StastnyJ/accelerometerPositionReader/src/sources.md

Files utilities.h, boards.cpp and boards.h are used for setup of the board. They were copied (and slightly changed) from [https://github.com/Xinyuan-LilyGO/LilyGO-T-Beam](https://github.com/Xinyuan-LilyGO/LilyGO-T-Beam).
