StastnyJ/accelerometerPositionReader/report/Report.pdf

## Substituting GPS with Gyroscope and Accelerometer

Jakub Sˇˇtastn´y

Student number: 03729788
Course: Real-time Systems [IN2060]

Abstract

I have built a device that measures the user’s current position and speed mainly using GPS and that tries to substitute the GPS with a gyroscope and an accelerometer in case of losing the GPS signal. I will describe the hardware from which the device is built in the first part. In the second part I will talk about the processing of accelerometer data, reducing measurements errors and calculating the final position of the device in the earth coordinates system. In the last part I will talk about the precision of the device and about the cause of the errors.

Substituting GPS with Gyroscope and Accelerometer | Jakub Sˇˇtastn´y

## 1 Project description

In this project I have built the device that shows the user his/her current position and speed on the display in a real time. In a normal case, the device is using only a GPS chip in order to get the information about the current location. But there are many cases when we lose a GPS signal. For example inside some buildings, between high mountains, in tunnels, etc. We want to have the device still running in these cases, so we have to substitute the GPS with some other alternative that is independent of the quality of a signal. I decided for the gyroscope and accelerometer that can measure our acceleration and angular speed, which can be using double integration converted to the relative location¹ and combined with the last location that the GPS measured before it lost the signal, in order to calculate the current location. With this technique we can keep the device running and providing the output to the user for the whole time even if we do not have any signal. Besides the controller board, accelerometer, gyroscope and display, the device contains two additional buttons. One of them is used for the (re)calibration of the device (described later). The second button is present only for the testing purpose and is used for the simulation of the situation that we do not have any GPS signal. If a user presses this button, he/she turns on the testing mode so that the device does not use any information from the GPS, even if it has a GPS signal and calculates the current speed and location only using the accelerometer and gyroscope data in order to simulate and test the situation that we do not have a GPS signal. If the user presses the button again, the testing mode is turned off and the device is working normally.
The device also has one additional LED, which indicates that the testing mode is turned on.

The whole project including all source codes, this report and photos is available on my github. https://github.com/StastnyJ/accelerometerPositionReader

## 2 Used hardware

For this project I used following hardware:

1. LILYGO TTGO T-Beam V1.1²
2. MPU-6050 3 Axis Gyro With Accelerometer³
3. OLED 128x64 I2C SSD1315 12864 LCD Screen Display module⁴
4. 2 Buttons, 1 LED and 18650 Battery

### 2.1 Controller board

As a microcontroller for this project, I used LILYGO TTGO T-Beam board version 1.1. This board is based on the ESP32 processor. It offers 4 MB Flash memory and 4 MB of PSRAM. The board also contains 2 additional modules. First of them is module LoRa32 which is used for wide area communication via bluetooth and WiFi. I haven’t used this module for the project. The second and for the project more important module is the NEO-6M module used for GPS. This module
can measure current gps location with the accuracy up to 2.5 meters⁵ | . This module communicates
with the ESP processor via integrated serial BUS in format of NMEA sentences⁶

1The location difference between our current location and location before the start of the acceleration measurement
2Detailed description: https://www.banggood.com/LILYGO-TTGO-T-Beam-ESP32-433-or-868-or-915-or-923Mhz-V1_

1-WiFi-Wireless-bluetooth-Module-GPS-NEO-6M-SMA-LORA32-18650-Battery-Holder-With-OLED-p-1545070.
html (https://www.banggood.com/LILYGO-TTGO-T-Beam-ESP32-433-or-868-or-915-or-923Mhz-V1_1-WiFi-Wireless-bluetooth-Module-GPS-NEO-6M-SMA-LORA32-18650-Battery-Holder-W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)
3Detailed description: https://www.banggood.com/3pcs-6DOF-MPU-6050-3-Axis-Gyro-With-Accelerometer-Sensor-Controller-Module-p-1430733.

html (https://www.banggood.com/3pcs-6DOF-MPU-6050-3-Axis-Gyro-With-Accelerometer-Sensor-Controller-Module-p-1430733.html)
4Detailed description: https://www.amazon.com/Serial-Display-Module-SSD1315-arduino/dp/B07Y5HNJGL
5This accuracy can be achieved only with a quite good antenna or a clear sky view. With the antenna I used for
the project is the accuracy between 15 and 20 meters.
6Described here: http://aprs.gids.nl/nmea/
1 | February 4, 2021

### 2.2 Gyroscope and Accelerometer

The MPU-6050 is a 3 axis gyroscope and accelerometer, which can communicate via I²C protocol. The accelerometer can measure the acceleration in the x, y, and z axis⁷
. With the configuration
I used to the project, the accelerometer can measure in each axe the acceleration in range from -2 g to 2 g with the sensitivity 6.1 · 10⁻⁵
g. The gyroscope can measure the angular speed of a board around each x, y and z axe. It can be measured in range from -250 ◦
s

−1

to 250 ◦
s

−1 with
the sensitivity 7.6 · 10⁻³ ◦ s

−1

### 2.3 Display

To display current speed and location to the user I used OLED 128x64 12864 LCD Screen Display. This display communicates again via I²C protocol. The screen is 128 pixels wide and 64 pixels high.

### 2.4 Circuit

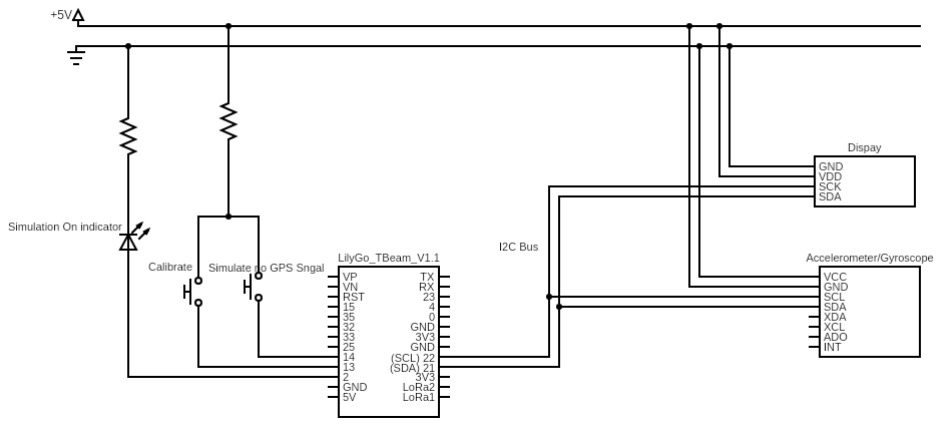
[picture p8: figure]

Figure 1: Circuit scheme (power supply of the TBeam board and power lines connection left out)

## 3 Reading and processing accelerometer and gyroscope data

The main challenge of the processing the accelerometer data is the fact that we receive the acceleration relatively to the accelerometer module and not relatively to the earth coordinate system and we need to convert them so we can calculate the final location. Furthermore, for the conversion we need an orientation of the board relatively to the earth coordinates which is not so easy to get without a tilt sensor or something similar.

### 3.1 Processing and converting raw data

As mentioned earlier, we obtain the accelerometer data relatively to the module axis. From the accelerometer and gyroscope we receive three 16-bit integers that correspond to the acceleration in x, y and z axes multiplied by 16384 in multiplies of g. After these 3 numbers, there follow three other 16-bit integers that correspond to the angular speed around x, y and z axes multiplied by 131 in degrees per second.

7The axis are defined relatively to the accelerometer and not in earth coordinate system

2 | February 4, 2021

For this part, let’s assume that we know the exact orientation of the module relatively to the earth coordinate system. If we know the orientation we can easily convert received acceleration data to the earth coordinates system that we convert received acceleration vector to the polar coordinates system, than we can easily rotate the vector by the orientation vector and then convert back to the Cartesian coordinates system and we obtain a vector of accelerations in x, y and z axe relatively to the earth coordinates system.

### 3.2 Device calibration

In this section I will talk about the way how can be obtained the orientation of the accelerometer module relatively to the earth coordinates system using only gyroscope and accelerometer. The calibration is a process that starts after a user presses the calibrate button and takes ca 10 seconds. During the calibration the device can be rotated as desired, but it must not move for the whole time. The main goal of the calibration is to obtain the orientation of the module relatively to the earth coordinates system. During the calibration we also calibrate the gyroscope so that it measures the correct data.
If the device is in calm, we expect the acceleration 0 in x and y axes and -1 g in z axe⁸
if the
module coordinates would be the same as the earth coordinates. During the calibration time we measure the current acceleration. In order to minimize the error of the measurement, we measure the acceleration multiple times and after we have enough measurements we can calculate the average value and use it for the further calculation. After theses measurements we have information about the calm acceleration relatively to the module which is usually different from the expected [0, 0, −1] g vector. At this point we can convert both vectors to the polar coordinates system and calculate the rotation differences between both vectors. In other words, we can calculate how we should rotate the measured vector so that we obtain the expected vector, which is the information about the module orientation that we need for the conversion to the earth coordinates system. At this point we know the initial orientation of the device. But this orientation can change during the usage of the device and changes quite often. To handle this, we can use the data from the gyroscope. The gyroscope measures the angular speed of the module, so if we detect that there is some angular speed around any axe different from 0, we know that the user tilted the device, and we can accordingly adjust our information about the orientation. Updating the orientation is the only part for which I am using the gyroscope in the project.
The last thing I am doing during the calibration process is the calibration of the gyroscope. Because of the construction error, almost each gyroscope has shifted the 0 levels of the angular speeds. During the calibration process I can also measure the gyroscope values (and calculate their average). Because the device is in calm, the measured values should be all 0, but because of the shift error, each value is shifted, so we obtain the error shift values that we can further subtract from the measured values in order to get the right angular speeds.

### 3.3 Data smoothing

From this point we know how to recalculate the measured values to the earth coordinates system, so we will assume that all accelerations are in the earth coordinates system.
In this section I will talk about the preparation of the measured data before we can start the final computation of the speed and location. The problem, why we shouldn’t directly calculate speed and location from the measured date, is that because of the double integration, even small measurement errors can have huge consequences, and we have to minimize these errors as much as possible. If we observe the values from the accelerometer, we can see that they are ”oscillating” around a real acceleration⁹
(See figures 2 and 3). This phenomenon could be partially solved with smoothing.
Now we assume that we have measured some data, let’s say n records, and we want to smooth them. Let’s choose a value b and divide the set of measured records into n
b

blocks of b consecutive
records. In each block we will find a median value of each x, y and z axe and set all records in the block to this median. This will cause that we will avoid or smooth these oscillations or a noise in the form of several random completely wrong records.

8This is caused by gravity, the [0, 0, 0] acceleration would be measured if the module was in a free fall
9This can be easily observed, if the device is in calm and the acceleration oscillates randomly around 0
3 | February 4, 2021

This smoothing technique is really simple, fast and reduces the errors quite well. The disadvantage of the smoothing is that we partially lose the precision level of the measurement. For example, if there were some really short acceleration that took only a short time, it could be assumed as an error and completely ignored. Or if we have a block where the acceleration is changing, we would lose the information about the shape of the curve, how the acceleration is changing, and we would assume it later as linear.
The level how much the data will be smoothed and how large the information lost is depends on the value of b. If we chose very small b, in the extreme case b = 1, we wouldn’t lose almost any information, but we would smooth really small blocks, so the smoothing wouldn’t have almost any effect and most of the errors will remain. On the other hand, if we choose a really large b, in extreme the case b = n, we will ignore almost all errors, but also almost every information we obtain, so the data would become almost useless.
In this project, I chose b = 16 records¹⁰. It is quite small, so we wouldn’t lose almost any information, because the change of the acceleration is in reality not so fast that the curves inside each block can be almost every time quite good approximated to the linear values. But it is not too small, and it smooths data quite well, especially if the device is not accelerating at all.

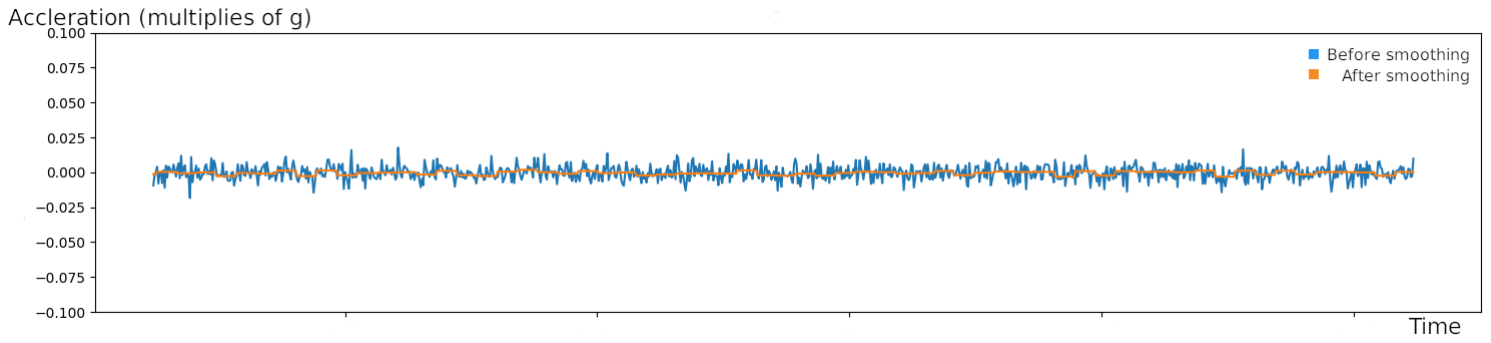
[picture p9: figure]

Figure 2: Acceleration on the x axe before and after smoothing when the device is in calm


Figure 3: Acceleration on the x axe before and after smoothing when the device is in motion

10And I am working with data sets with n = 512 records, so I divide them into 32 blocks. More about it in the next section.

4 | February 4, 2021

After the data are smoothed, we could apply another technique to reduce an error. Even after smoothing, if the device does not accelerate, we can still get some small positive or negative accelerations, which need to be removed. To do that, we can choose some limit l and then assume every acceleration, which is in the absolute value lower than the limit, as 0. For the project, I chose l = 0.03125 g.

### 3.4 Calculating final speed and location

Now we have reduced the measurement error, and we can finally calculate the final location. Let’s assume we know the initial speed v0 and location p0 of the device¹¹ and the set of n last acceleration measurements together with the times of the measurement.
To calculate a velocity and a position from the acceleration, we need to convert the discrete values into a continuous function. Because the time differences between measurements are quite small, compared to expected accelerations, we can assume that between every 2 measurement results there is the acceleration constant and approximate our discrete function to the continuous one in the way displayed in the Figure 4.


Figure 4: Approximating discrete measurements to continuous function

Now, we have all information we need to calculate a velocity as

v(t) = v0 +

Zt

Tstart

a(τ ) dτ

Where v0 is initial speed, Tstart is a time of the first record in the measurements set, Tend is time of the last record and a(t) is the approximated acceleration function from the measurements. The value v(Tend) will be final speed used as initial speed for the next measurement.
When we know also the function of velocity with respect to time, we can integrate it again to obtain our relative position with respect to the last know position.

pr =

T
Zend

Tstart

v(t) dt

Now we have a relative position pr, so we can convert it from meters to longitude and latitude degrees and add it to the last known location p0 and obtain our current location.
The last thing we have to do is to choose the appropriate number of records n that we will collect before we recalculate the location. If we chose n relatively small, we would recalculate the position quite often, so the user would see the information about the position always up to date. If we chose n quite large, it would take some time before we collected enough data to recalculate the location, and the user would have to wait some time before he/she sees the new updated values. But on the other hand, the larger n we choose, the more data we have to calculate and we can perform more appropriate error correction, function approximation, and we also have denser data because we only collect them and we do not always recalculate the position, so we can obtain more accurate values.

11The initial speed will be 0 after calibration or result of the last calculation. The initial position will be last the record from GPS, before we lost the signal or result of the last calculation

5 | February 4, 2021

In the project, I chose n = 512. We have quite enough data to do appropriate error corrections and collecting + recalculating takes a bit less than one second, so the data is almost always up to date¹²

### 3.5 Position recalculating pseudocode

If I sum up all previous steps into a pseudocode, it will look like this.

1. Let v0 and p0 be initial speed and location
2. measure data until you have n records
3. smooth the data
4. v := calculate speed from the smoothed data
5. p := calculate relative position from the smoothed data
6. p

0
:= convert relative position to the earth the coordinates units
7. p0 := p0 + p

0

8. v0 := v
9. delete measured data
10. goto step 2

## 4 Results and precision

Now let’s talk about the results and the precision I achieved with the accelerometer. To measure the precision, we can define an error as a ratio

E =

pe − p
pe

where pe is the expected relative position¹³ and p is the position calculated by the device.
For quite short distances, up to 10 m, the device was working quite well, with E < 0.1, which corresponds to the error lower than one meter for every 10 meters.


Figure 5: Device error for small distances (average from several measurements)

12The target user is a human not another machine, so updating state in less than one second is fast enough 13Measured with my phone

6 | February 4, 2021

But if we continue with the measurement for the larger distances, from several tens to several hundred meters, we will see that the error grows exponentially and is quite soon really huge. If we recalibrate the device during the measurement and then continue measuring, we will shortly stop the grow, but after quite a short while we will get back to the exponential grow.


(a) Without a calibration | (b) With 2 calibrations

Figure 6: Device error tendency for larger distances¹⁴

The question is, why is the error growing exponentially. One reason is the double integration of the acceleration, the error of the acceleration measurement will be propagated[3] and ends up in the exponential of its value, so it has large consequences even if it is quite small. The other reason is that the value depends on the previous results, especially on the previous velocity, and if these values are wrong because of the measurement error, the next error would be larger and larger, which also leads to the exponential grow of the error.
But the main factor causing the error is the translation from the accelerometer coordinate system, in which the accelerations are measured, to the earth coordinates system. This translation depends on the knowledge of the orientation of the device, which is determined during the calibration and updated according to the data from the gyroscope, which can also be inaccurate, so after some time, we have a wrong orientation vector, which significantly increase the error of the data from the accelerometer (mainly because of the gravity vector which will be reflected also in x and y axes) which will lead to huge errors described in previous paragraph. The fact that the error stopped growing for a while after a recalibration also suggests that the main cause of the error is the wrong orientation.

## 5 Conclusion

In conclusion of this project, I would say that accelerometer is not an appropriate substitution for GPS and because of the errors described in the previous section, it is an inappropriate type of sensor for each application where we have to know a precise location in a different coordinate system, than the one which is relative to the sensor/device. Maybe if we would combine the accelerometer with a tilt sensor or any other sensor which allows direct measuring of the orientation of the device with respect to the earth coordinates system, then it could deliver better results, but the error of using only an accelerometer with a gyroscope is too large for any real application.

14I deliberately left out the units because the actual numbers were different for each measurement, depending on how much I was accelerating, changing directions or rotating with the device, but the tendency and shape of the curve was always the same.

7 | February 4, 2021

## References

[1] Accelerometer and Gyro Tutorial. url: https://www.instructables.com/Accelerometer-Gyro-Tutorial (https://www.instructables.com/Accelerometer-Gyro-Tutorial) (visited on 01/28/2021).
[2] Gyro desc. url: https://invensense.tdk.com/products/motion-tracking/6-axis/mpu-6050/ (https://invensense.tdk.com/products/motion-tracking/6-axis/mpu-6050/) (visited on 01/30/2021).
[3] Integral uncernity error propagation. url: http://www.m4ssl.npl.co.uk/wp- content/ uploads/2012/02/Determining- the- uncertainty- associated- with- integrals- ofspectral-quantities.pdf (http://www.m4ssl.npl.co.uk/wp-content/uploads/2012/02/Determining-the-uncertainty-associated-with-integrals-of-spectral-quantities.pdf) (visited on 02/02/2021).
[4] LilyGo LoRa Series. url: https://github.com/Xinyuan-LilyGO/LilyGO-T-Beam (visited on 01/28/2021).
[5] NMEA sentences. url: http://aprs.gids.nl/nmea/ (visited on 01/30/2021).

February 4, 2021
