StastnyJ/accelerometerPositionReader/photos/IMG_20210205_012730.jpg

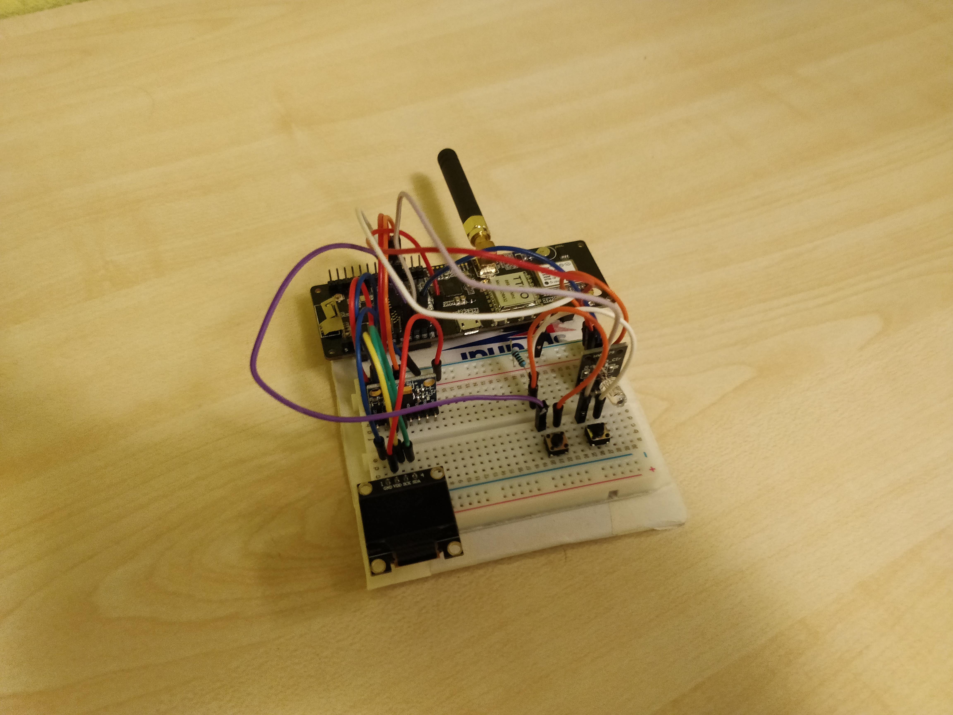
photos/IMG_20210205_012730.jpg
