StastnyJ/accelerometerPositionReader/photos/IMG_20210205_012736.jpg

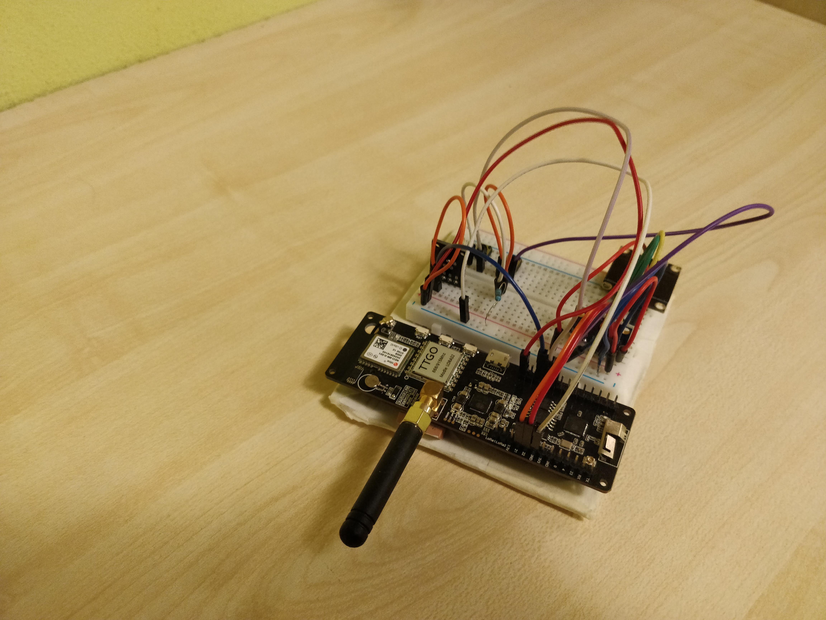
photos/IMG_20210205_012736.jpg
