StastnyJ/accelerometerPositionReader/photos/IMG_20210205_012817.jpg

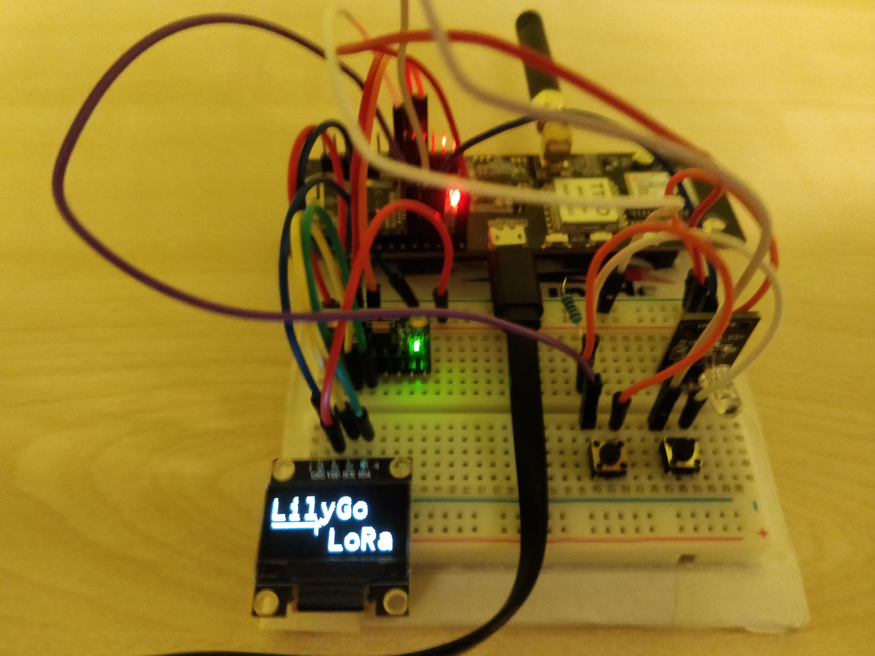
photos/IMG_20210205_012817.jpg
