StastnyJ/accelerometerPositionReader/photos/IMG_20210205_012832.jpg

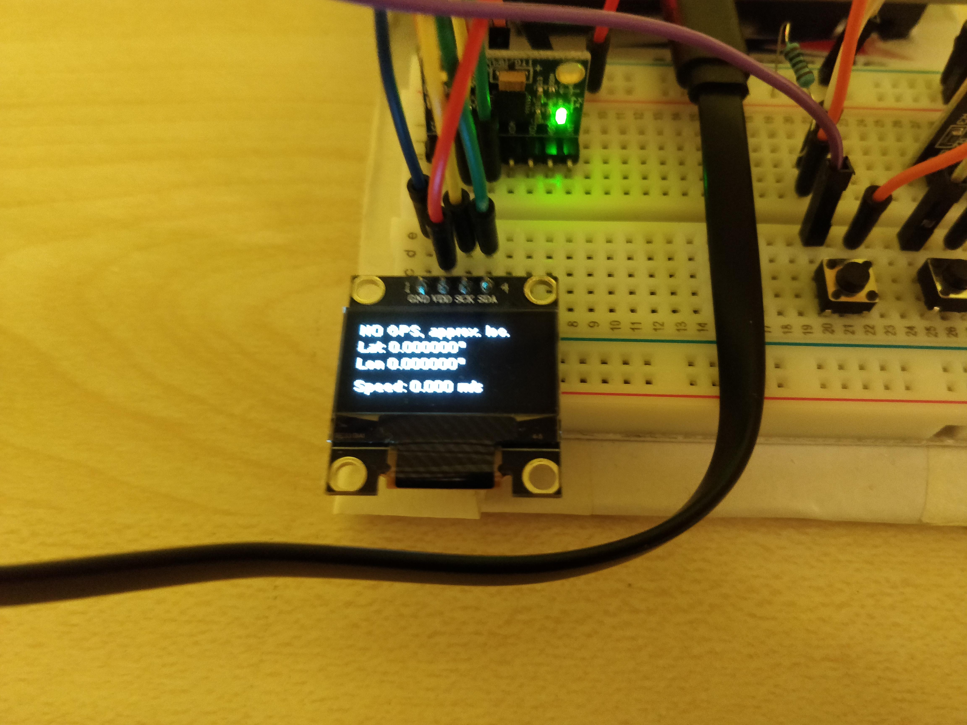
photos/IMG_20210205_012832.jpg
