StastnyJ/accelerometerPositionReader/photos/IMG_20210205_012840.jpg

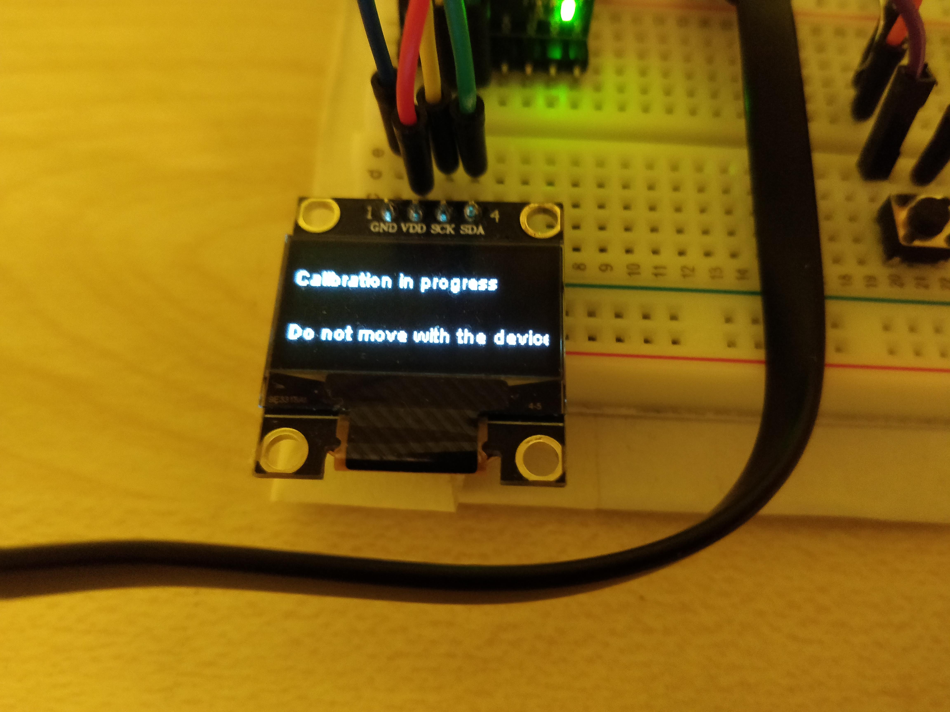
photos/IMG_20210205_012840.jpg
