StastnyJ/accelerometerPositionReader/photos/IMG_20210205_013002.jpg

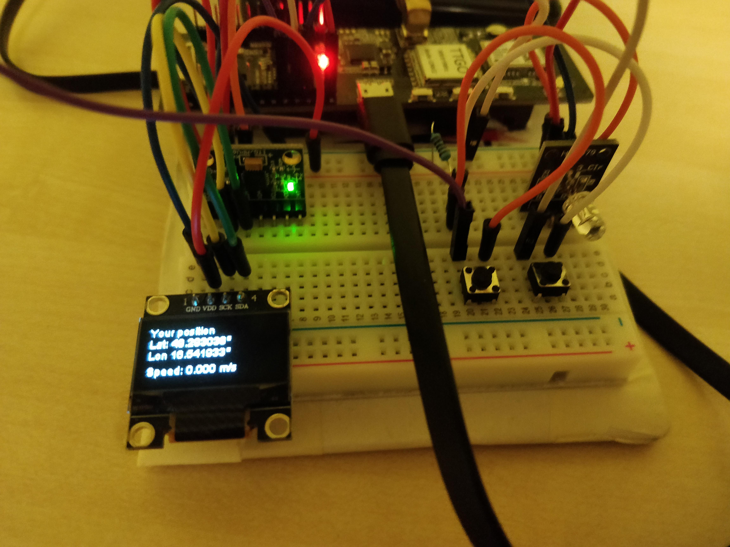
photos/IMG_20210205_013002.jpg
