StastnyJ/accelerometerPositionReader/photos/IMG_20210205_013031.jpg

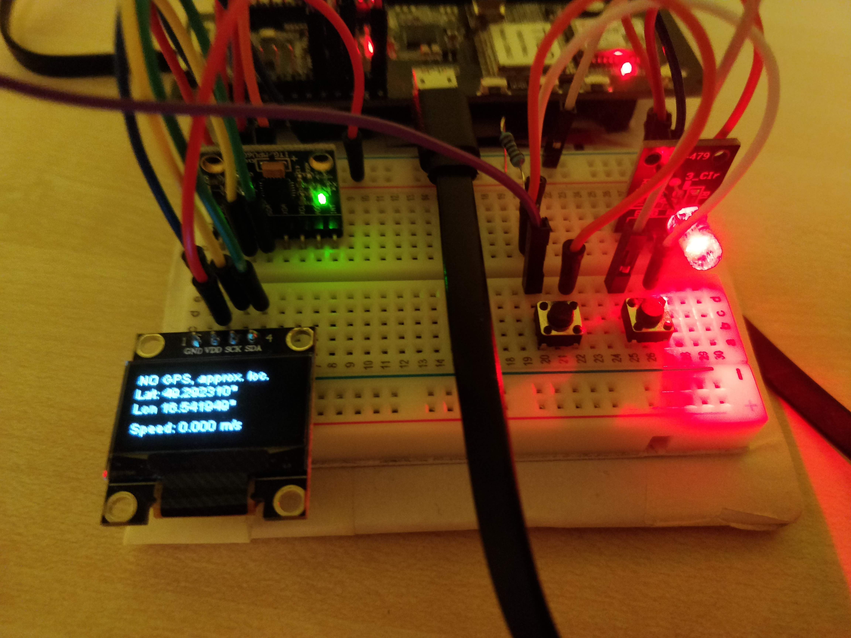
photos/IMG_20210205_013031.jpg
